tum-gis/sensor-nodes/adafruit_32u4_with_display/README.rst

Adafruit 32u4 LoRa with Display
===============================

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

Hardware
--------

To build this sensor node we have used following hardware components:

- `Adafruit Feather 32u4 LoRa module <https://www.adafruit.com/product/3078>`_
- `Grove - DHT-22 Temperature & Humidity Sensor <http://wiki.seeedstudio.com/Grove-Temperature_and_Humidity_Sensor_Pro/>`_
- `LED Display <https://learn.adafruit.com/14-segment-alpha-numeric-led-featherwing>`_
- `Breadboard <https://en.wikipedia.org/wiki/Breadboard#/media/File:400_points_breadboard.jpg>`_
- `Battery <https://www.adafruit.com/product/2011>`_
- `Resistor: 4.7k to 10k Ohm <https://learn.sparkfun.com/tutorials/resistors/all>`_
- `3d-Printed case <https://www.thingiverse.com/thing:2209964>`_

Microcontroller
^^^^^^^^^^^^^^^

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

Sensor
^^^^^^

We have attached a DHT22 sensor to the microcontroller board, which
measures air temperature and humidity. The minimal time interval between
two measurements is 2 seconds. All data transfers between the DHT22 and
the microcontroller use a single digital line. The sensor data pin is
attached to a GPIO pin (here: Digital Pin 6) of the microcontroller. In
addition, a so-called pull-up resistor of 4.7k to 10k Ohm must be connected
between the data line and VCC (+3.3V). The
`DHT22 datasheet <https://www.sparkfun.com/datasheets/Sensors/Temperature/DHT22.pdf>`_
provides more technical details about the DHT22 Sensor. A tutorial on
`how to use the DHT22 sensor with Arduino <https://learn.adafruit.com/dht?view=all>`_
microcontrollers is provided here. The sensor is available in German shops
for around 4 € to 10 €.



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

Display / Beeper
^^^^^^^^^^^^^^^^

On top of the microcontroller board we have attached an `Adafruit Display
Wing with a 4 digit 14 segments LED display <https://learn.adafruit.com/14-segment-alpha-numeric-led-featherwing>`_.
It can show 0-4 numbers or letters (upper case and lower case). The
display controller is using the `I2C protocol <https://en.wikipedia.org/wiki/I%C2%B2C>`_
and the I2C pins SDA and SCL are directly connected to the Adafruit Feather
via the Wing connectors. The Wing is using the default I2C address (0x70).
Also a 3.3V beeper is installed that is used to indicate that a new message
was received and is now being displayed. The '+' pin of the beeper has to be
connected to Digital Pin 12 and the '-' pin to GND. The display and the beeper
can be used to notify a user with (very) short messages. The reason why we
have included this is mostly to experiment with and to demonstrate the downlink
capabilities of LoRaWAN. When a downlink message has been queued it will be
transmitted to the node right after it has transmitted the next data packet
(uplink data). Hence, it depends on the transmission time period how long
it can take unless the node receives and displays a downlink message.

Case
^^^^

The case was 3D printed using the
`design files provided by Adafruit <https://learn.adafruit.com/3d-printed-case-for-adafruit-feather/overview>`_.
The case consists of three parts. Part 1 is the main enclosure (it does not
have a switch holder or tabs, the design file is feather-case.stl). Part 2
is the battery holder (with a slide switch holder, the design file is
feather-bat-switch.stl). Part 3 is the case topper (with a cutout for the
Adafruit Feather Wing, the design file is feather-top-wing.stl). All design
files can be downloaded from `Thingiverse <https://www.thingiverse.com/thing:2209964>`_.

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

Software
--------

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

Now download and run the :ref:`Arduino_Sketch_Adafruit_32u4-Display.ino`
file in the Arduino IDE. This code was created by merging the example
code of both the sensors and the ttn-otaa example from the lmic library.
Some required changes were made while merging the example codes. The user
should change the network session key, app session key and device address
in the code before compiling. These keys can be obtained from the TTN
account as shown in the `services section <#services>`_.

.. literalinclude:: Arduino_Sketch_Adafruit_32u4-Display/Arduino_Sketch_Adafruit_32u4-Display.ino
   :language: arduino
   :linenos:
   :caption: Modify the keys in highlighted lines.
   :name: Arduino_Sketch_Adafruit_32u4-Display.ino_Keys
   :lines: 189-204
   :emphasize-lines: 4,8,15

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

.. literalinclude:: Arduino_Sketch_Adafruit_32u4-Display/Arduino_Sketch_Adafruit_32u4-Display.ino
   :language: arduino
   :linenos:
   :caption: Code for measuring the battery voltage
   :name: Arduino_Sketch_Adafruit_32u4-Display.ino_BatteryVoltage
   :lines: 441-451

Services
--------

The services used for this sensor-node are:

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

Registration of the sensor node with The Things Network (TTN)
^^^^^^^^^^^^^^^^^^^^^^^^^^^^^^^^^^^^^^^^^^^^^^^^^^^^^^^^^^^^^

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

The sketch given above connects the sensor node with The Things Network
(TTN) using the Over-the-Air-Activation (OTAA) mode. In this mode, we
use the three keys AppEUI, DevEUI, AppKey. The DevEUI should be
delivered with the sensor node by the manufacturer, the other two
keys are created using the TTN console. Each sensor node must be
manually registered in the `TTN console <https://console.thethingsnetwork.org>`_
before it can be started. This assumes that you already have a TTN
user account (which needs to be created otherwise). `In the TTN console
create a new device <https://www.thethingsnetwork.org/docs/devices/registration.html>`_
and enter the DevEUI number that was shipped with the Adafruit Feather
LoRa board. Note that the shipped number only consists of 6 bytes
while LoRaWAN requires an 8 bytes DevEUI. We simply add 0x00 0x00
in the middle of the 6 bytes provided. If you have lost the provided
DevEUI you can also let the TTN console create a new one. After the
registration of the device the respective keys (AppEUI, DevEUI, AppKey)
can be copied from the TTN console and must be pasted into the the
proper places in the source code of the sketch above. Please make
sure that you choose for each of the three keys the correct byte
ordering (DevEUI, AppEUI in LSB; AppKey in MSB). A detailed explanation
of these steps is `given here <https://learn.adafruit.com/the-things-network-for-feather?view=all>`_.
Then the sketch can be compiled and uploaded to the Adafruit Feather
32u4 LoRa microcontroller. Note that the three constants (AppEUI, DevEUI,
AppKey) must be changed in the source code for every new sensor node.

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

TTN Payload Decoding
^^^^^^^^^^^^^^^^^^^^

Everytime a data packet is received by a TTN application a dedicated
Javascript function is being called (Payload Decoder Function). This
function can be used to decode the received byte string and to create
proper Javascript objects or values that can directly be read by humans
when looking at the incoming data packet. This is also useful to format
the data in a specific way that can then be forwarded to an external
application (e.g. a sensor data platform like `MyDevices <https://mydevices.com/>`_
or `Thingspeak <https://thingspeak.com/>`_). Such a forwarding can be
configured in the TTN console in the "Integrations" tab. :ref:`TTN_Payload_Decode.js`
given here checks if a packet was received on LoRaWAN port 7 and then
assumes that it consists of the 6 bytes encoded as described above.
It creates the three Javascript objects 'temperature', 'humidity',
and 'vbattery'. Each object has two fields: 'value' holds the value
and 'uom' gives the unit of measure. The source code can simply be
copied and pasted into the 'decoder' tab in the TTN console after
having selected the application. Choose the option 'Custom' in the
'Payload Format' field. Note that when you also want to handle other
sensor nodes sending packets on different LoRaWAN ports, then the
Payload Decoder Function can be extended after the end of the  if
(port==7) {...} statement by adding  else if (port==8) {...} else
if (port==9) {...} etc.

The Things Network - OGC SensorWeb Integration
^^^^^^^^^^^^^^^^^^^^^^^^^^^^^^^^^^^^^^^^^^^^^^^

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

We are running an instance of the 52° North SOS and the TTN-OGC
SWE Integration. The web client for this LoRaWAN sensor node can
be accessed `on this page <http://129.187.38.201:8080/ttn-sos-integration/static/client/helgoland/index.html#/diagram?ts=ttnOGC__30,ttnOGC__29,ttnOGC__28>`_.
Here is a screenshot showing the webclient:



  Web client for data visualization

Sending a message to the Sensor Node (Downlink)
^^^^^^^^^^^^^^^^^^^^^^^^^^^^^^^^^^^^^^^^^^^^^^^

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

Code files
----------

.. literalinclude:: Arduino_Sketch_Adafruit_32u4-Display/Arduino_Sketch_Adafruit_32u4-Display.ino
   :language: arduino
   :linenos:
   :caption: Arduino Sketch for Adafruit32u4 LoRa with display sensor node
   :name: Arduino_Sketch_Adafruit_32u4-Display.ino

.. literalinclude:: TTN_Payload_Decode.js
   :language: Javascript
   :linenos:
   :caption: TTN payload decoder for Adafruit32u4 LoRa with display sensor node
   :name: TTN_Payload_Decode.js

References
----------

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

**On battery saving / using the deep sleep mode**

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
