tum-gis/sensor-nodes/Indoor Ambient Monitoring with Seeeduino LoRaWAN/hardware.jpg

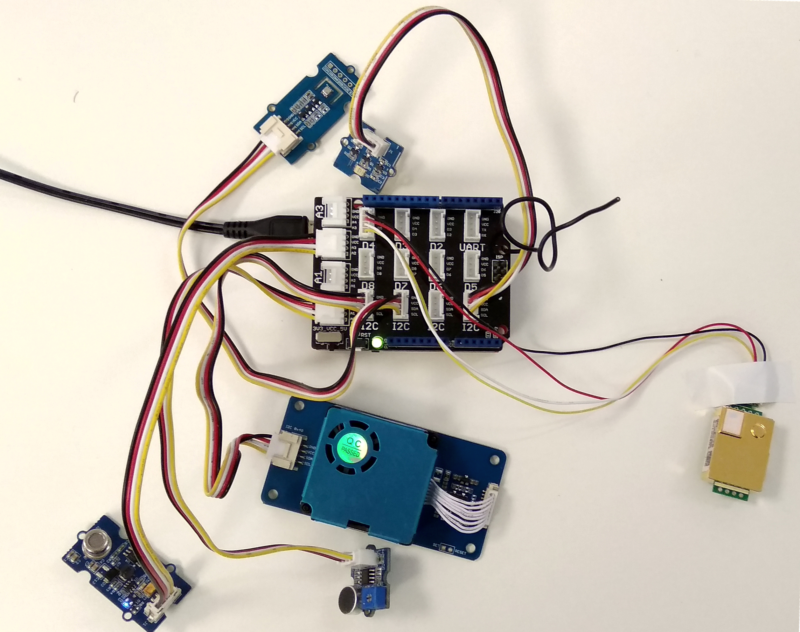
Indoor Ambient Monitoring with Seeeduino LoRaWAN/hardware.jpg
