tum-gis/sensor-nodes/FeatherM0LoRa in TFA Housing/setup-bottom.jpg

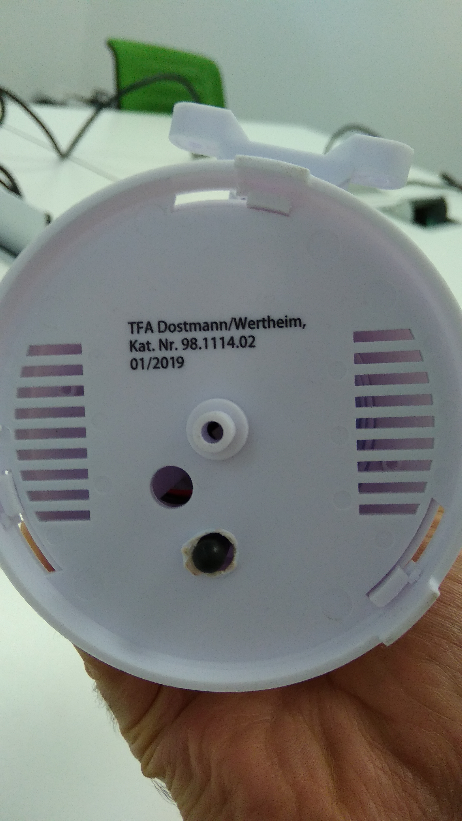
FeatherM0LoRa in TFA Housing/setup-bottom.jpg
