tum-gis/sensor-nodes/(threads)

Thread 3 (2020-01-16):

Feather M0 LoRa in TFA Housing - Altitude wrong

BWibo, 2020-01-16:
The altitude values appear to be wrong. They alternate roughly between -1 and +1.

Closed 2023-06-21.
